icamaster/picothermal/enclosure/picothermal-bot-0.8mm.stl

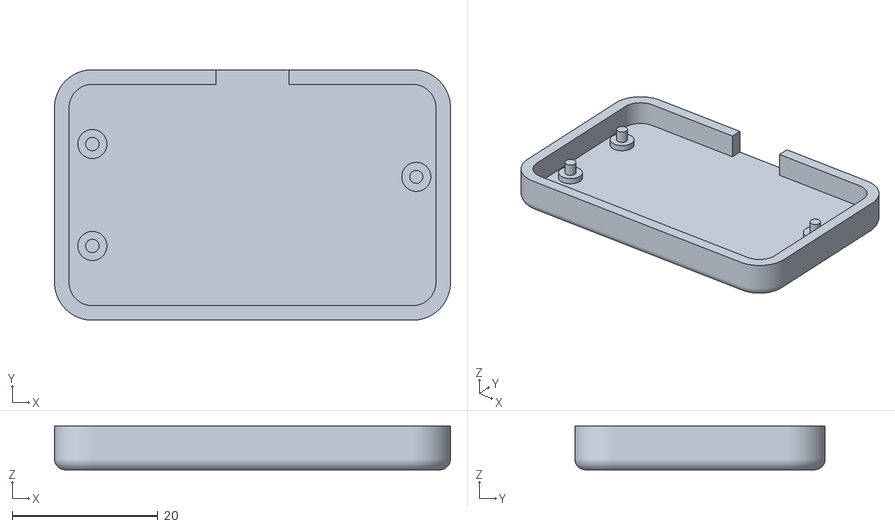
[picture p3: CAD file, 2026-10-12]
enclosure/picothermal-bot-0.8mm.stl
54.4 x 34.4 x 6.00
