icamaster/picothermal/enclosure/picothermal-bot-1.6mm.stl

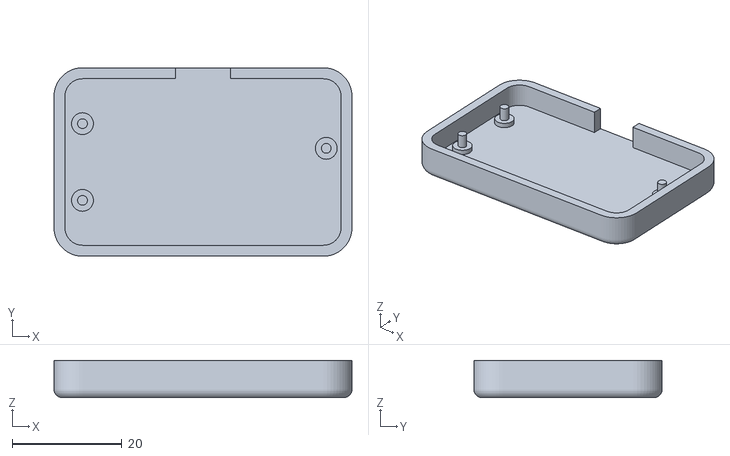
[picture p4: CAD file, 2026-10-12]
enclosure/picothermal-bot-1.6mm.stl
54.4 x 34.4 x 6.80
