icamaster/picothermal/enclosure/picothermal-hardware.step

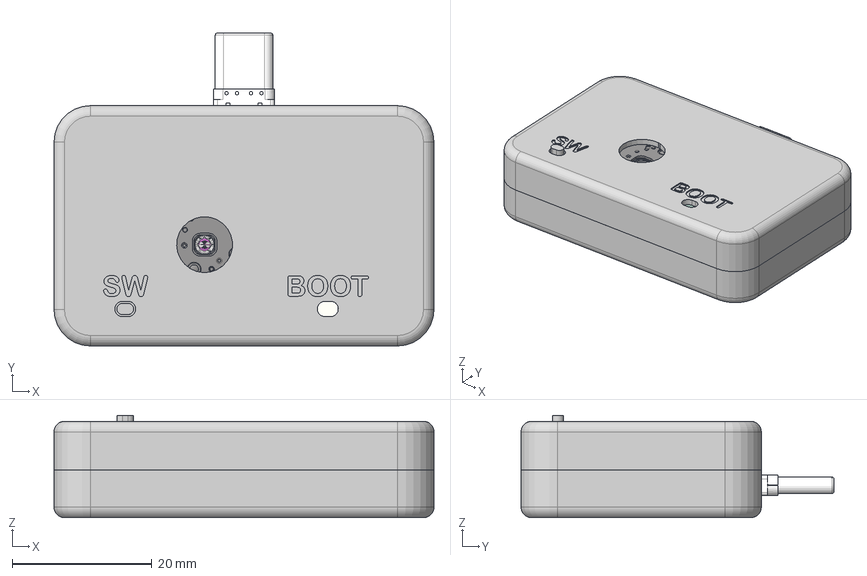
[picture p5: CAD file, 2026-10-12]
enclosure/picothermal-hardware.step
54.4 x 44.8 x 14.7 mm
Lepton Base, Export_Export
Assy, Housing, 160x120 Lens, Lepton 3.0 Export
Emissive Shutter, Lepton, Export
picothermal-hardware PCB
