icamaster/picothermal/enclosure/picothermal-top.stl

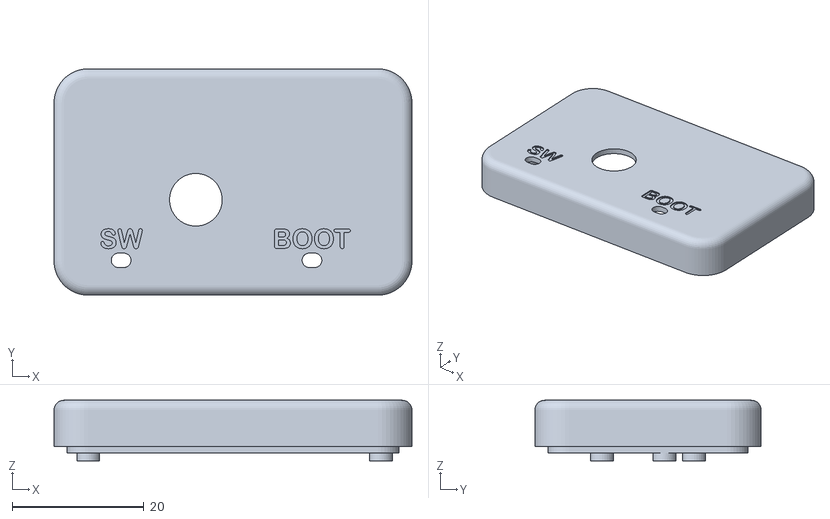
[picture p6: CAD file, 2026-10-12]
enclosure/picothermal-top.stl
54.4 x 34.4 x 9.20
