icamaster/picothermal/enclosure/picothermal-button.stl

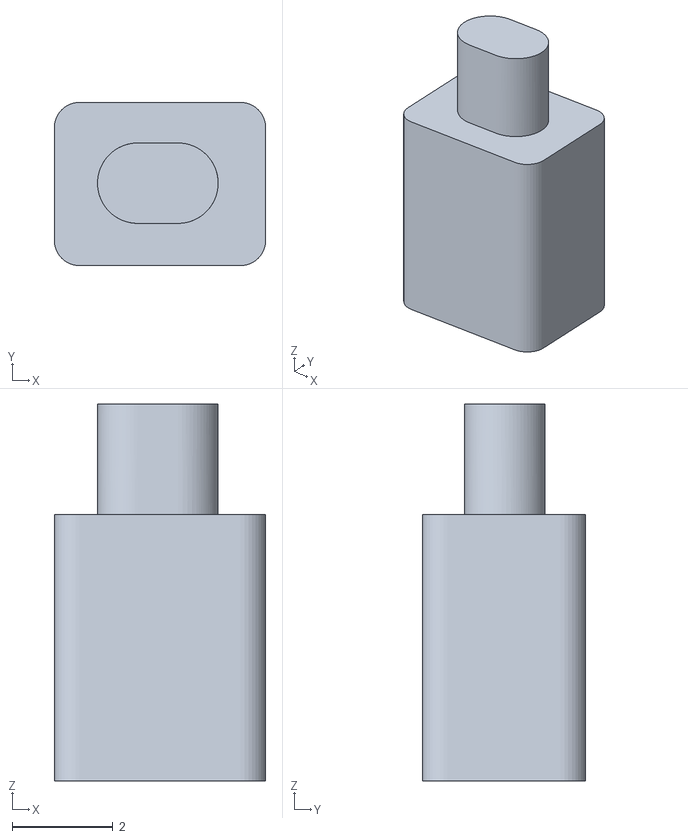
[picture p7: CAD file, 2026-10-12]
enclosure/picothermal-button.stl
4.20 x 3.25 x 7.50
