icamaster/picothermal/picothermal-hardware/OutputJob/picothermal-hardware-1.0/Schematic/picothermal-hardware.pdf

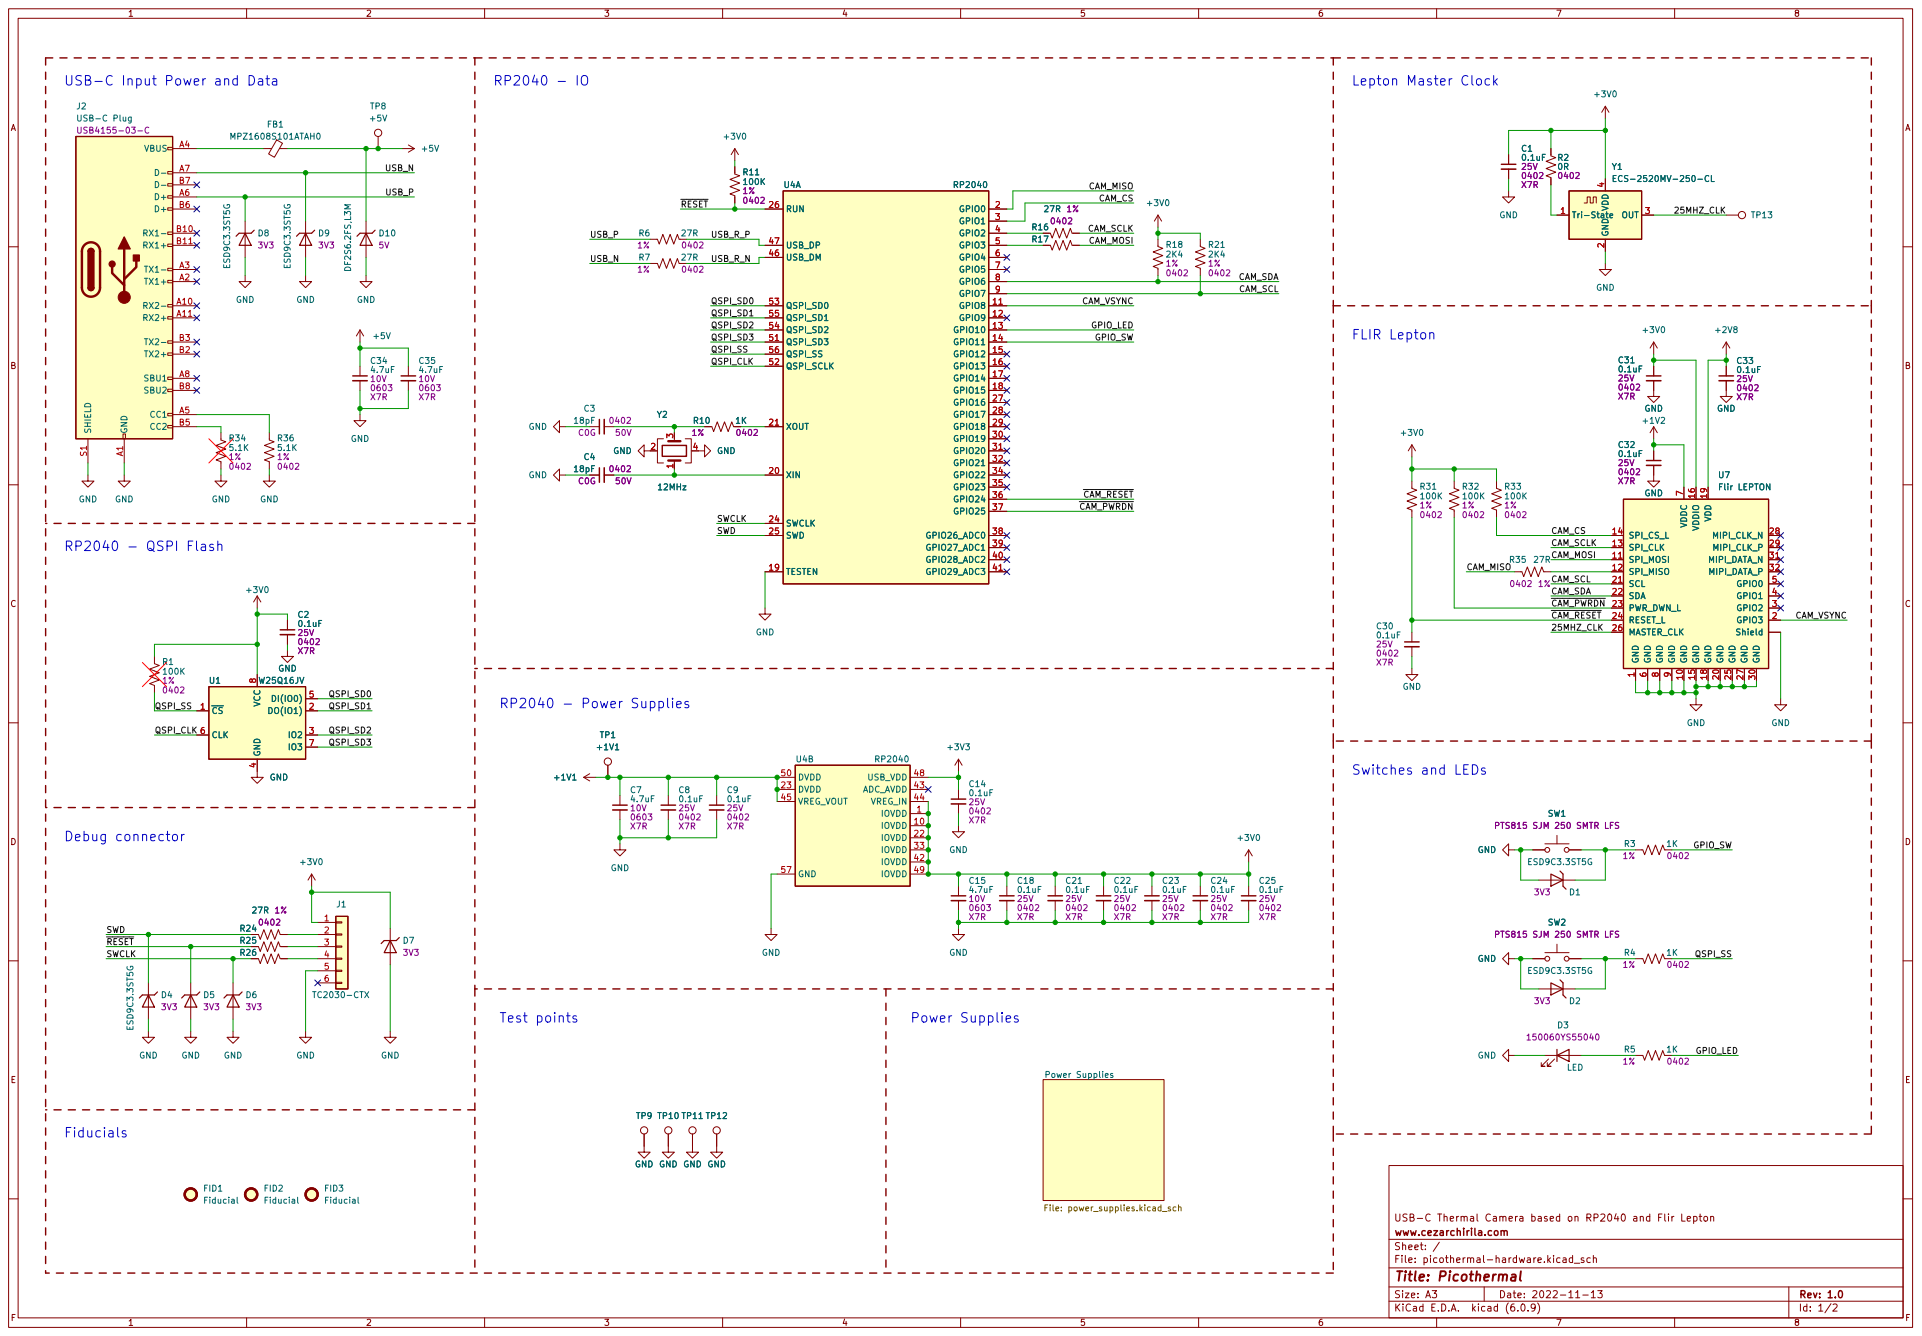
[picture p8: page 1]

USB-C Input Power and Data

1 GND 10 SPI_MOSI 11 SPI_MISO 12 SPI_CLK 13 SPI_CS_L 14 GND 15 VDDIO 16 GND 18 VDD 19 GPIO3

SW2 PTS815 SJM 250 SMTR LFS GND GND

USB-C Thermal Camera based on RP2040 and Flir Lepton
File: picothermal-hardware.kicad_sch Sheet: / www.cezarchirila.com

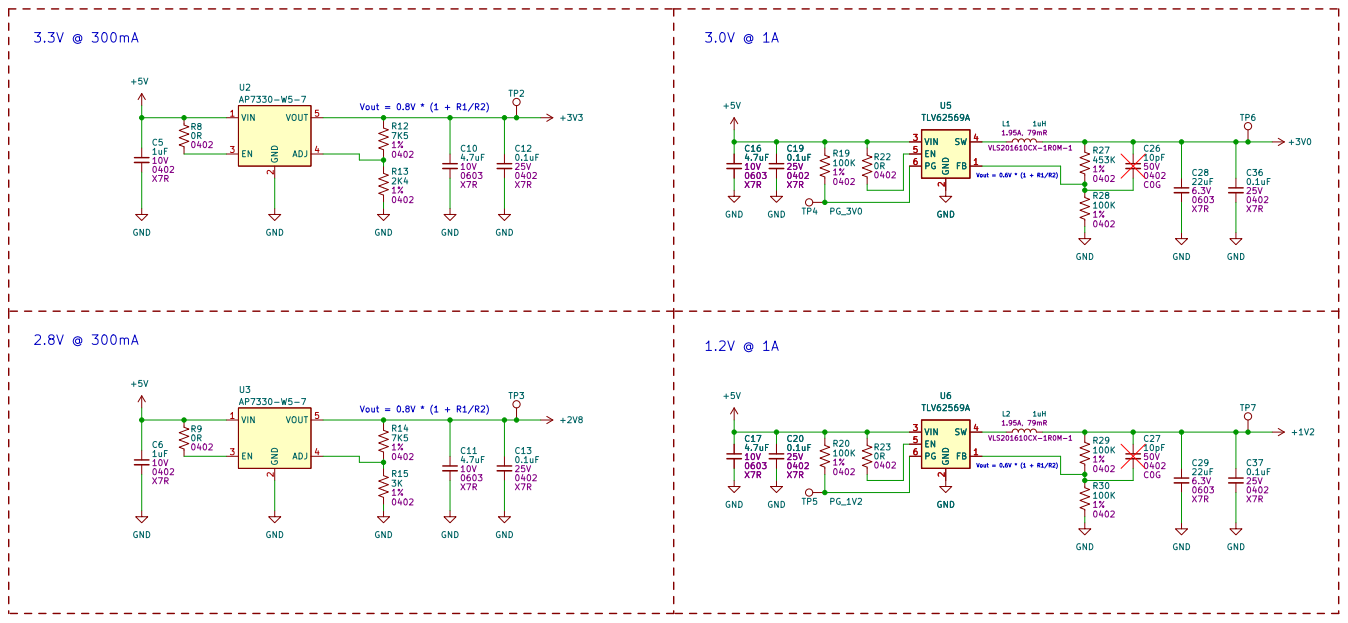
[picture p9: page 2]

2 VIN 3 SW 4 EN 5 PG 6 U5 TLV62569A R28

2 VIN 3 SW 4 EN 5 PG 6 GND

2 EN 3 ADJ 4 VOUT 5 U3AP7330-W5-7 GND

2 VIN 3 SW 4 EN 5 PG 6 U6 TLV62569A

2 VIN 3 SW 4 EN 5 PG 6 C17

USB-C Thermal Camera based on RP2040 and Flir Lepton GND

Sheet: /Power Supplies/ www.cezarchirila.com
