icamaster/picothermal/picothermal-hardware/OutputJob/picothermal-hardware-1.0/Assembly/picothermal-hardware-assembly.pdf

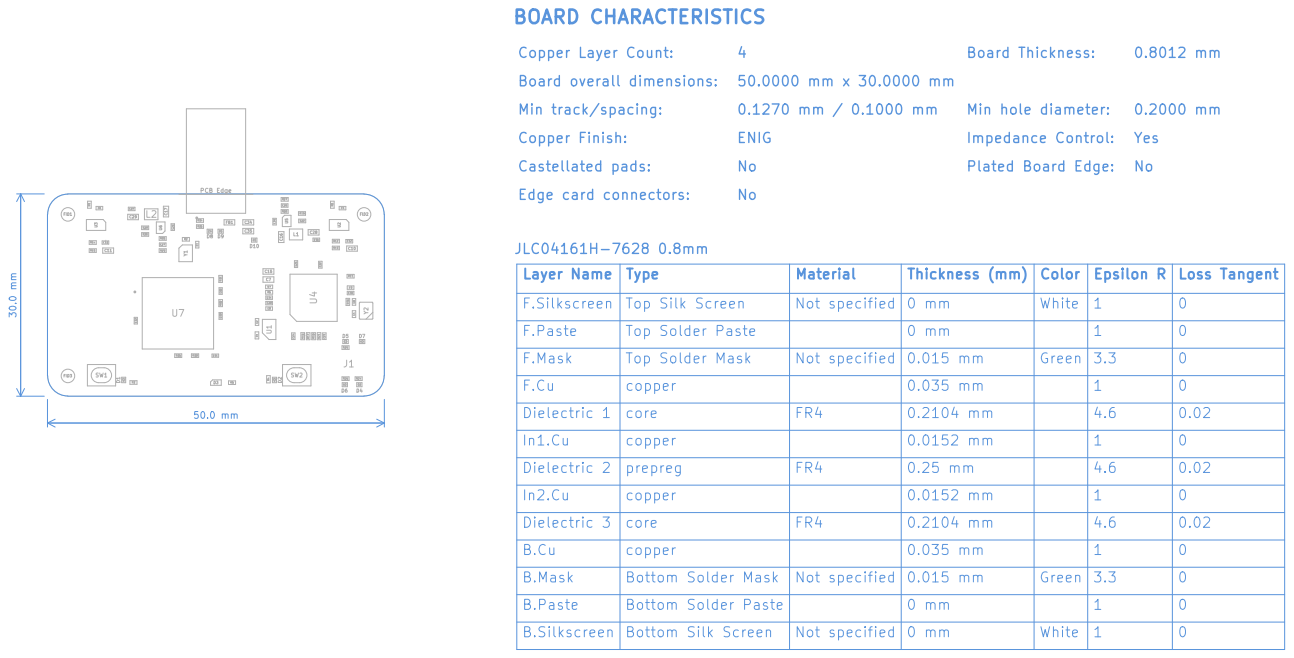
[picture p10: page 1]
