icamaster/picothermal/picothermal-hardware/picothermal-hardware.kicad_pcb

## KiCad design picothermal-hardware/picothermal-hardware.kicad_pcb (2023-03-19)

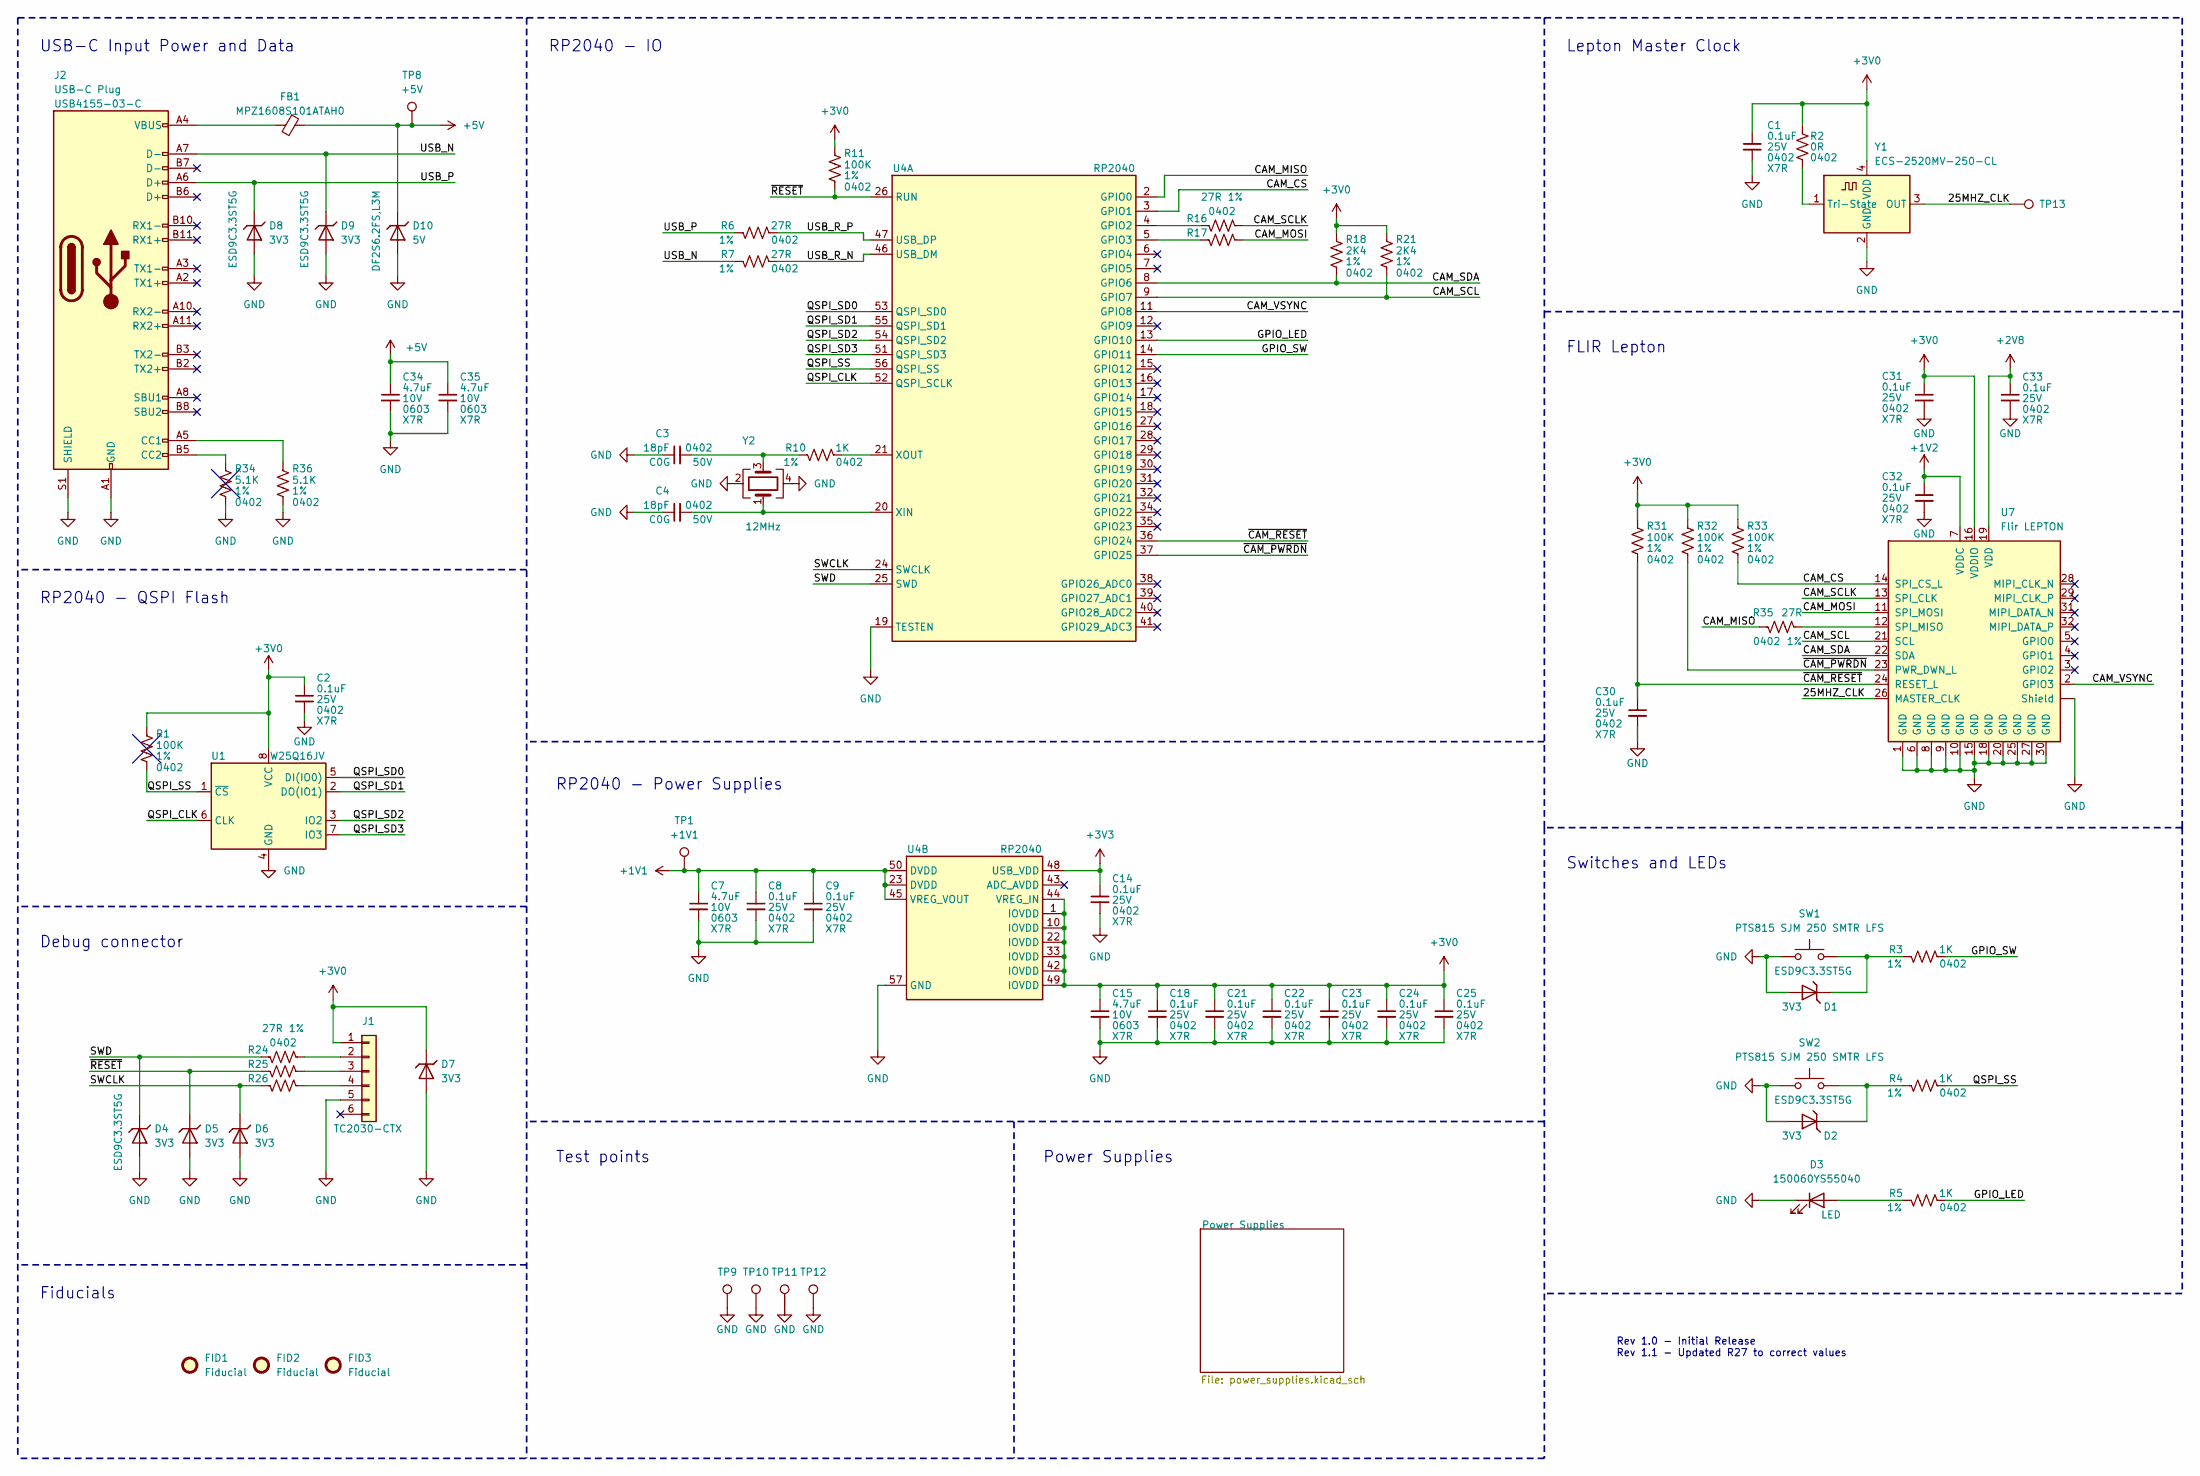
[picture p11: schematic picothermal-hardware.kicad_sch, Picothermal]

Parts:
C1, C2, C8, C9, C14, C18, C21, C22, C23, C24, C25, C30, C31, C32, C33: 0.1uF; C_0402_1005Metric; Voltage Rating 25V
C3, C4: 18pF; C_0402_1005Metric; Voltage Rating 50V
C7, C15, C34, C35: 4.7uF; C_0603_1608Metric; Voltage Rating 10V
D1, D2, D4, D5, D6, D7, D8, D9: ESD9C3.3ST5G; D_SOD-923; Part Number ESD9C3.3ST5G
D3: LED; LED_0603_1608Metric; Part Number 150060YS55040
D10: DF2S6.2FS,L3M; D_SOD-923; Part Number DF2S6.2FS,L3M
FB1: MPZ1608S101ATAH0; L_0603_1608Metric; Part Number MPZ1608S101ATAH0
FID1, FID2, FID3: Fiducial; Fiducial_1mm_Mask2mm
J1: TC2030-CTX; Tag-Connect_TC2030-IDC-NL_2x03_P1.27mm_Vertical
J2: USB-C Plug; USB_C_Plug_GCT_USB4155; Part Number USB4155-03-C
R1, R11, R31, R32, R33: 100K; R_0402_1005Metric; Tolerance 1%
R2: 0R; R_0402_1005Metric; Tolerance 1%
R3, R4, R5, R10: 1K; R_0402_1005Metric; Tolerance 1%
R6, R7, R16, R17, R24, R25, R26, R35: 27R; R_0402_1005Metric; Tolerance 1%
R18, R21: 2K4; R_0402_1005Metric; Tolerance 1%
R34, R36: 5.1K; R_0402_1005Metric; Tolerance 1%
SW1, SW2: SW_Push; SW_SPST_PTS815; Part Number PTS815 SJM 250 SMTR LFS
TP1: +1V1; TestPoint_Pad_D1.0mm
TP8: +5V; TestPoint_Pad_D1.0mm
TP9, TP10, TP12: GND; TestPoint_Pad_D1.0mm
TP11: GND; TestPoint_Plated_Slot_5.0x2.5
TP13: 25MHz; TestPoint_Pad_D1.0mm
U1: W25Q16JV; USON-8_2x3mm; Part Number W25Q16JVUXIQ
U4: RP2040; QFN-56-1EP_7x7mm_P0.4mm_EP3.2x3.2mm; Part Number RP2040
U7: Flir LEPTON; MOLEX_105028-1001; Part Number 105028-1001
Y1: ECS-2520MV-250-CL; Oscillator_SMD_ECS_2520MV-xxx-xx-4Pin_2.5x2.0mm
Y2: 12MHz; Crystal_SMD_2520-4Pin_2.5x2.0mm; Part Number ECS-120-12-36-AGN-TR3

Connections:
+1V1: C7.1, C8.1, C9.1, TP1.1, U4.23 (DVDD), U4.45 (VREG_VOUT), U4.50 (DVDD)
+1V2: C32.1, U7.7 (VDDC); also elsewhere on the board
+2V8: C33.1, U7.19 (VDD); also elsewhere on the board
+3V0: C1.1, C2.1, C15.1, C18.1, C21.1, C22.1, C23.1, C24.1, C25.1, C31.1, D7.1 (K), J1.1, R1.1, R2.1, R11.1, R18.1, R21.1, R31.1, R32.1, R33.1, U1.8 (VCC), U4.1 (IOVDD), U4.10 (IOVDD), U4.22 (IOVDD), U4.33 (IOVDD), U4.42 (IOVDD), U4.44 (VREG_IN), U4.49 (IOVDD), U7.16 (VDDIO), Y1.4 (VDD); also elsewhere on the board
+3V3: C14.1, U4.48 (USB_VDD); also elsewhere on the board
+5V: C34.1, C35.1, D10.1 (K), FB1.1, TP8.1; also elsewhere on the board
/25MHZ_CLK: TP13.1, U7.26 (MASTER_CLK), Y1.3 (OUT)
/CAM_CS: R33.2, U4.3 (GPIO1), U7.14 (SPI_CS_L)
/CAM_MISO: R35.2, U4.2 (GPIO0)
/CAM_MOSI: R17.1, U7.11 (SPI_MOSI)
/CAM_SCL: R21.2, U4.9 (GPIO7), U7.21 (SCL)
/CAM_SCLK: R16.1, U7.13 (SPI_CLK)
/CAM_SDA: R18.2, U4.8 (GPIO6), U7.22 (SDA)
/CAM_VSYNC: U4.11 (GPIO8), U7.2 (GPIO3)
/GPIO_LED: R5.1, U4.13 (GPIO10)
/GPIO_SW: R3.1, U4.14 (GPIO11)
/QSPI_CLK: U1.6 (CLK), U4.52 (QSPI_SCLK)
/QSPI_SD0: U1.5 (DI(IO0)), U4.53 (QSPI_SD0)
/QSPI_SD1: U1.2 (DO(IO1)), U4.55 (QSPI_SD1)
/QSPI_SD2: U1.3 (IO2), U4.54 (QSPI_SD2)
/QSPI_SD3: U1.7 (IO3), U4.51 (QSPI_SD3)
/QSPI_SS: R1.2, R4.1, U1.1 (~CS), U4.56 (QSPI_SS)
/SWCLK: D6.1 (K), R26.2, U4.24 (SWCLK)
/SWD: D4.1 (K), R24.2, U4.25 (SWD)
/USB_N: D9.1 (K), J2.A7 (D-), R7.2
/USB_P: D8.1 (K), J2.A6 (D+), R6.2
/USB_R_N: R7.1, U4.46 (USB_DM)
/USB_R_P: R6.1, U4.47 (USB_DP)
/~CAM_PWRDN: R32.2, U4.37 (GPIO25), U7.23 (PWR_DWN_L)
/~CAM_RESET: C30.1, R31.2, U4.36 (GPIO24), U7.24 (RESET_L)
/~RESET: D5.1 (K), R11.2, R25.2, U4.26 (RUN)
GND: C1.2, C2.2, C3.1, C4.1, C7.2, C8.2, C9.2, C14.2, C15.2, C18.2, C21.2, C22.2, C23.2, C24.2, C25.2, C30.2, C31.2, C32.2, C33.2, C34.2, C35.2, D1.2 (A), D2.2 (A), D3.1 (K), D4.2 (A), D5.2 (A), D6.2 (A), D7.2 (A), D8.2 (A), D9.2 (A), D10.2 (A), J1.5, J2.A1 (GND), J2.A12 (GND), J2.B1 (GND), J2.B12 (GND), J2.S1 (SHIELD), R34.2, R36.2, SW1.1, SW2.1, TP9.1, TP10.1, TP11.1, TP12.1, U1.4 (GND), U4.19 (TESTEN), U4.57 (GND), U7.1 (GND), U7.6 (GND), U7.8 (GND), U7.9 (GND), U7.10 (GND), U7.15 (GND), U7.17 (NC), U7.18 (GND), U7.20 (GND), U7.25 (GND), U7.27 (GND), U7.30 (GND), U7.Shield, Y1.2 (GND), Y2.2, Y2.4; also elsewhere on the board
unnamed: C3.2, R10.2, Y2.3
unnamed: D1.1 (K), R3.2, SW1.2
unnamed: D2.1 (K), R4.2, SW2.2
unnamed: D3.2 (A), R5.2
unnamed: FB1.2, J2.A4 (VBUS), J2.A9 (VBUS), J2.B4 (VBUS), J2.B9 (VBUS)
unnamed: J1.2, R24.1
unnamed: J1.3, R25.1
unnamed: J1.4, R26.1
unnamed: J2.A5 (CC1), R36.1
unnamed: J2.B5 (CC2), R34.1
unnamed: R16.2, U4.4 (GPIO2)
unnamed: R17.2, U4.5 (GPIO3)
unnamed: C4.2, U4.20 (XIN), Y2.1
unnamed: R10.1, U4.21 (XOUT)
unnamed: R35.1, U7.12 (SPI_MISO)
unnamed: R2.2, Y1.1 (Tri-State)

Notes on the sheet:
Rev 1.0 - Initial Release Rev 1.1 - Updated R27 to correct values
FLIR Lepton
RP2040 - QSPI Flash
Test points
USB-C Input Power and Data
Fiducials
RP2040 - Power Supplies
Debug connector
Lepton Master Clock
RP2040 - IO
Switches and LEDs
Power Supplies

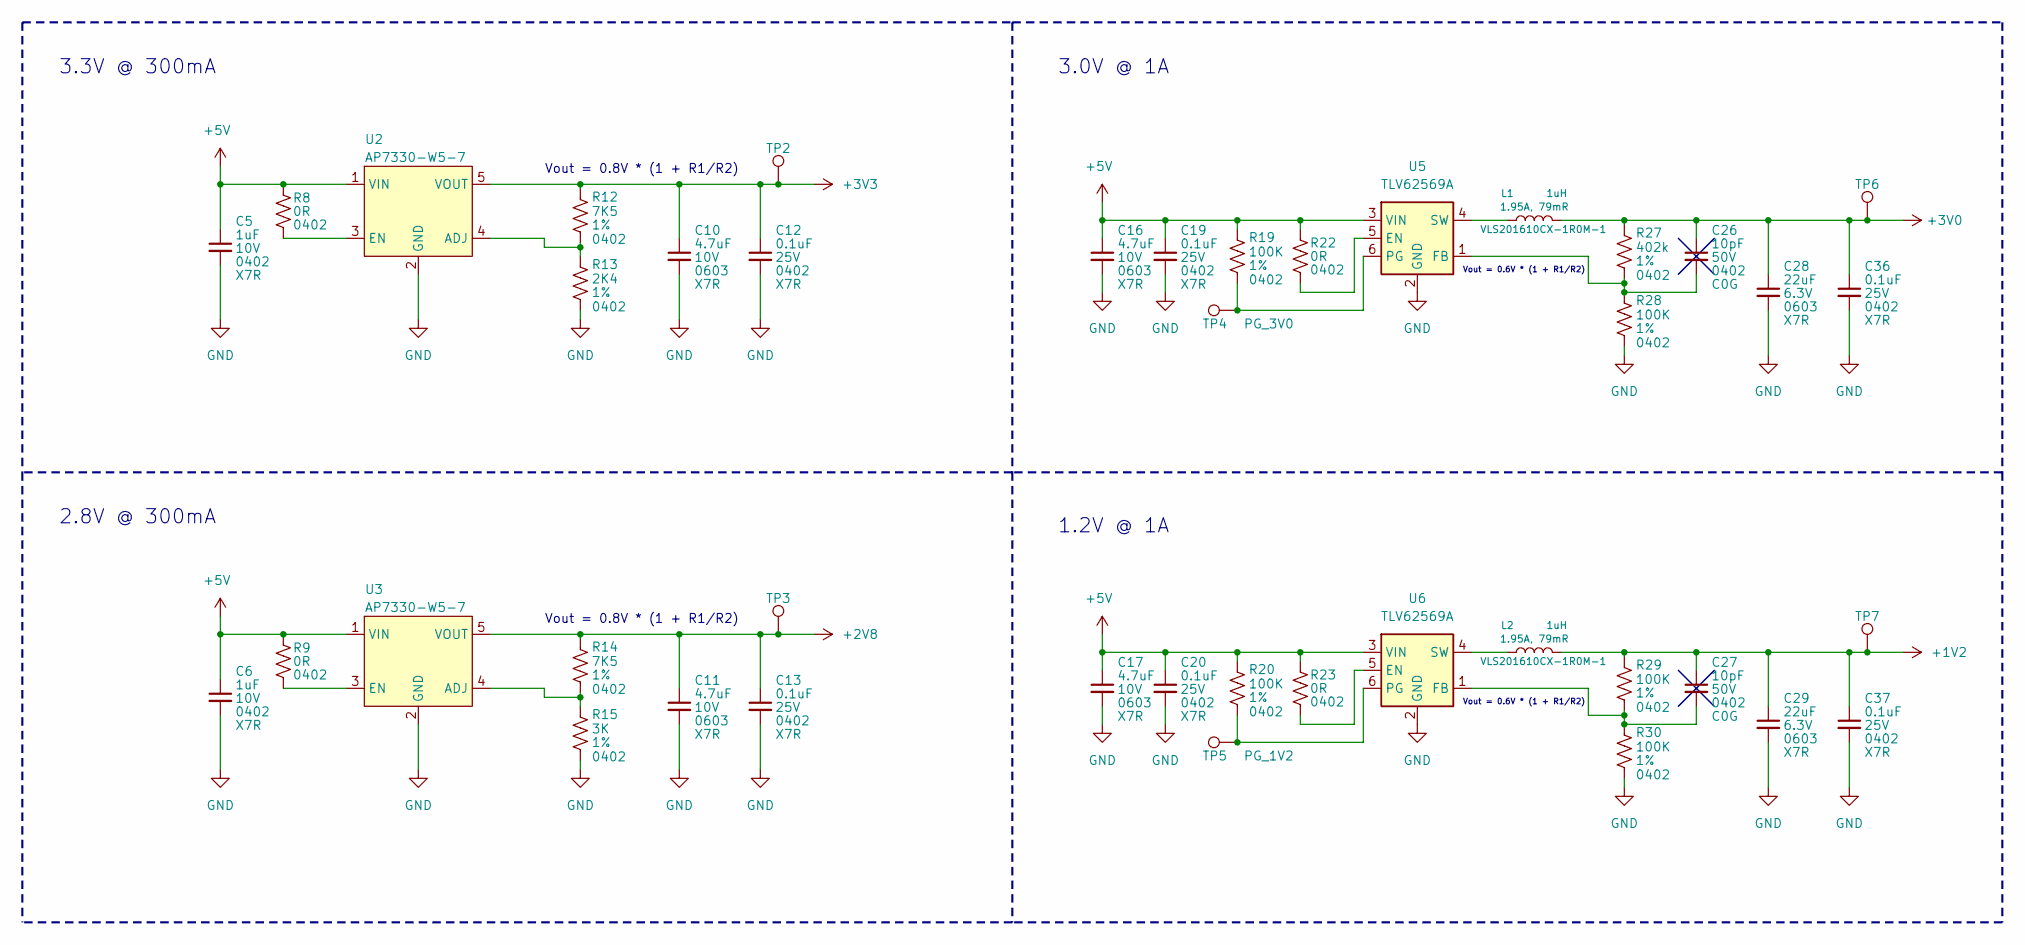
[picture p12: schematic power_supplies.kicad_sch, Picothermal]

Parts:
C5, C6: 1uF; C_0402_1005Metric; Voltage Rating 10V
C10, C11, C16, C17: 4.7uF; C_0603_1608Metric; Voltage Rating 10V
C12, C13, C19, C20, C36, C37: 0.1uF; C_0402_1005Metric; Voltage Rating 25V
C26, C27: 10pF; C_0402_1005Metric; Voltage Rating 50V
C28, C29: 22uF; C_0603_1608Metric; Voltage Rating 6.3V
L1, L2: 1uH; L_TDK_VLS201610CX-1; Part Number VLS201610CX-1R0M-1
R8, R9, R22, R23: 0R; R_0402_1005Metric; Tolerance 1%
R12, R14: 7K5; R_0402_1005Metric; Tolerance 1%
R13: 2K4; R_0402_1005Metric; Tolerance 1%
R15: 3K; R_0402_1005Metric; Tolerance 1%
R19, R20, R28, R29, R30: 100K; R_0402_1005Metric; Tolerance 1%
R27: 402k; R_0402_1005Metric; Tolerance 1%
TP2: 3V3; TestPoint_Pad_D1.0mm
TP3: 2V8; TestPoint_Pad_D1.0mm
TP4: PG_3V0; TestPoint_Pad_D1.0mm
TP5: PG_1V2; TestPoint_Pad_D1.0mm
TP6: 3V0; TestPoint_Pad_D1.0mm
TP7: 1V2; TestPoint_Pad_D1.0mm
U2, U3: AP7330-W5-7; SOT-25-5; Part Number AP7330-W5-7
U5, U6: TLV62569A; SOT-563; Part Number TLV62569APDRLR

Connections:
+1V2: C27.1, C29.1, C37.1, L2.2, R29.1, TP7.1; also elsewhere on the board
+2V8: C11.1, C13.1, R14.1, TP3.1, U3.5 (VOUT); also elsewhere on the board
+3V0: C26.1, C28.1, C36.1, L1.2, R27.1, TP6.1; also elsewhere on the board
+3V3: C10.1, C12.1, R12.1, TP2.1, U2.5 (VOUT); also elsewhere on the board
+5V: C5.1, C6.1, C16.1, C17.1, C19.1, C20.1, R8.1, R9.1, R19.1, R20.1, R22.1, R23.1, U2.1 (VIN), U3.1 (VIN), U5.3 (VIN), U6.3 (VIN); also elsewhere on the board
GND: C5.2, C6.2, C10.2, C11.2, C12.2, C13.2, C16.2, C17.2, C19.2, C20.2, C28.2, C29.2, C36.2, C37.2, R13.2, R15.2, R28.2, R30.2, U2.2 (GND), U3.2 (GND), U5.2 (GND), U6.2 (GND); also elsewhere on the board
unnamed: R12.2, R13.1, U2.4 (ADJ)
unnamed: R8.2, U2.3 (EN)
unnamed: R14.2, R15.1, U3.4 (ADJ)
unnamed: R9.2, U3.3 (EN)
unnamed: R22.2, U5.5 (EN)
unnamed: C26.2, R27.2, R28.1, U5.1 (FB)
unnamed: R19.2, TP4.1, U5.6 (PG)
unnamed: L1.1, U5.4 (SW)
unnamed: R23.2, U6.5 (EN)
unnamed: C27.2, R29.2, R30.1, U6.1 (FB)
unnamed: R20.2, TP5.1, U6.6 (PG)
unnamed: L2.1, U6.4 (SW)

Notes on the sheet:
2.8V @ 300mA
Vout = 0.8V * (1 + R1/R2)
3.0V @ 1A
Vout = 0.6V * (1 + R1/R2)
1.2V @ 1A
3.3V @ 300mA

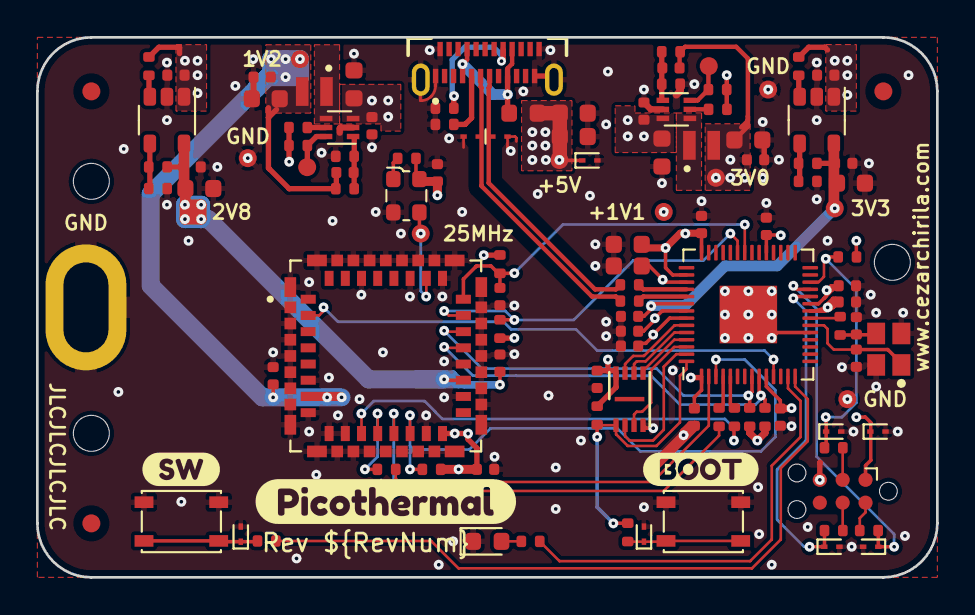
[picture p13: board picothermal-hardware.kicad_pcb from above]

Board: 4 copper layers, 50.0 x 30.0 mm, 118 parts (0 on the bottom side), 60 nets.

Other parts of the board:
kibuzzard-63AA0E75: G***; kibuzzard-63AA0E75
kibuzzard-63AA0EB3: G***; kibuzzard-63AA0EB3
kibuzzard-63AA0F05: G***; kibuzzard-63AA0F05
