icamaster/picothermal/(commit log)

2022-12-26 PCB Layout is now complete
2023-02-02 Regenerate output using latest version and add step and interactive BOM
2023-03-19 Updated hardware project to work with Kicad 7.0
2026-10-12 Update enclosure
